coder543-footprints/josh_footprints.pretty/RK09K1130A8G.STEP

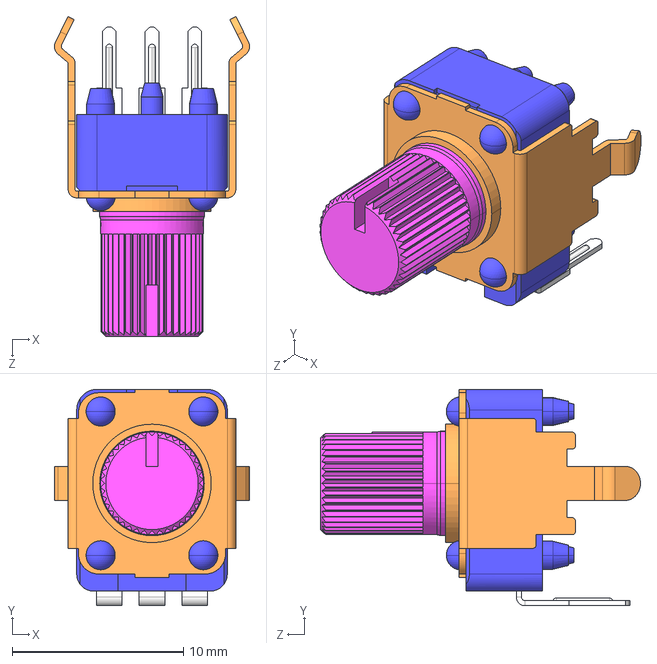
[picture p1: CAD file, 2016-01-30]
RK09K1130A8G.STEP
11.4 x 12.7 x 18.7 mm
