coder543-footprints/josh_footprints.pretty/(commit log)

2015-08-23 added first footprint
2015-10-03 Added ABM3C crystal footprint.
2015-12-29 Added several footprints
2016-01-30 added additional footprints
    [RK09K1130A8G.STEP]
2016-02-14 updated TSL2561 footprint
2016-03-17 Added FT231XS footprint
2016-05-21 Improved FT231XS footprint, added generic chinese display module.
2016-06-24 added misc footprints
